flavioamieiro/dmx_servo_controller/README.md

# dmx_servo_controller

AMIEIRO + DELED : SERVO DMX Controller V0.1
