flavioamieiro/dmx_servo_controller/DMX_servo_controller_hardware/README.md

DMX servo controller

This source describes Open Hardware and is licensed under the CERN-OHL-S v2.
You may redistribute and modify this source and make products using it under
the terms of the [CERN-OHL-S v2](https://ohwr.org/cern_ohl_s_v2.txt).

Source location: https://github.com/flavioamieiro/Neopixel-Pico-Arcade

As per CERN-OHL-S v2 section 4, should You produce hardware based on this
source, You must where practicable maintain the Source Location visible on the
external case of the Gizmo or other products you make using this source.
