flavioamieiro/dmx_servo_controller/(threads)

Thread 1 (2023-08-16):

DmxInput: start_channel is not honored

MatheusMeM, 2023-08-16:
ORIGINAL:

https://github.com/jostlowe/Pico-DMX/issues/15](https://github.com/jostlowe/Pico-DMX/issues/15#issue-1080333671)
