flavioamieiro/dmx_servo_controller/DMX_servo_controller_hardware/DMX_servo_controller_hardware.pdf

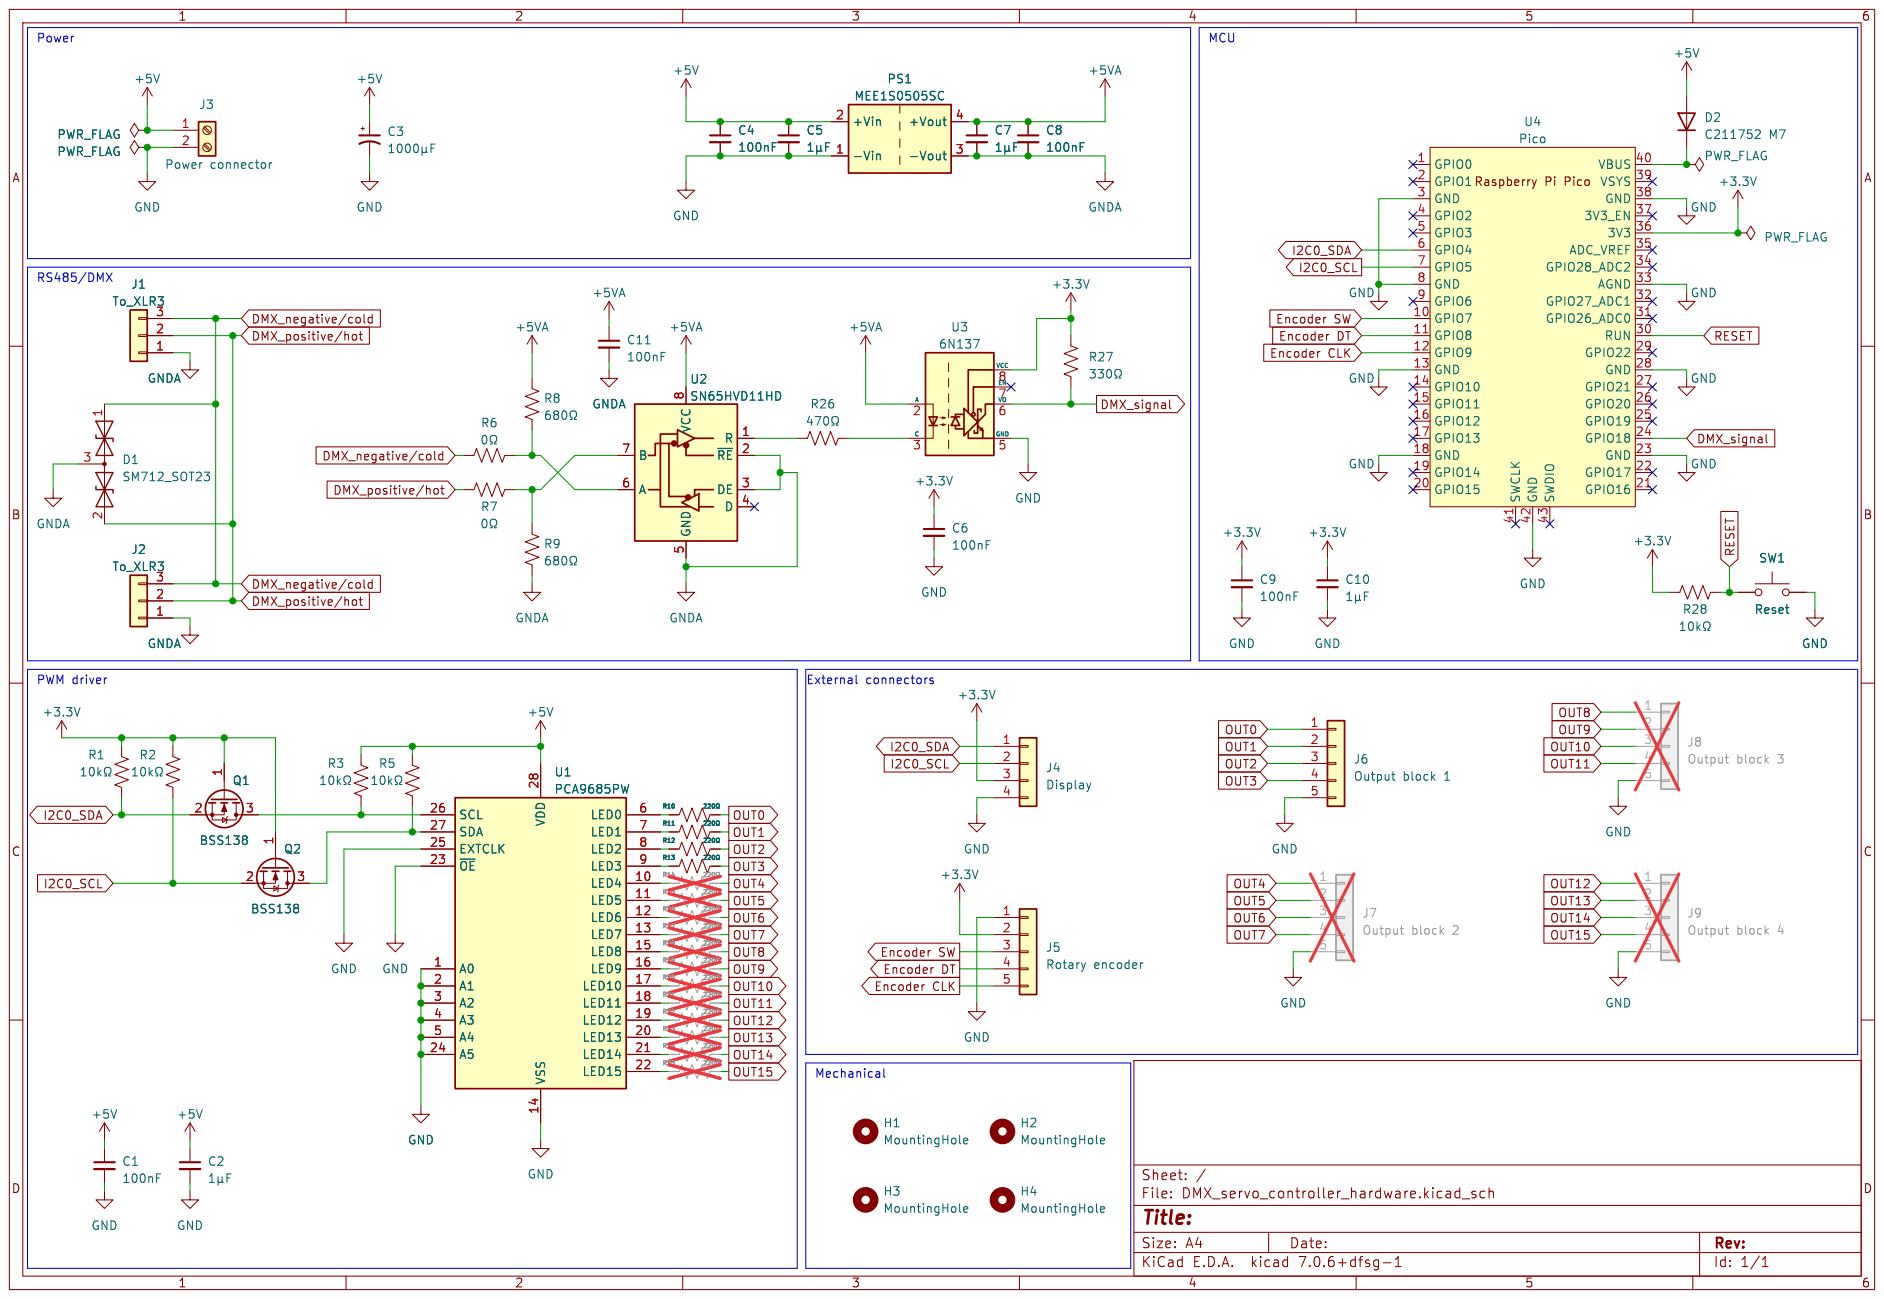
[picture p1: page 1]

Id: 1/1 Title: File: DMX_servo_controller_hardware.kicad_sch Sheet: /
