flavioamieiro/dmx_servo_controller/PWM_breakout_board/PWM_breakout_board.pdf

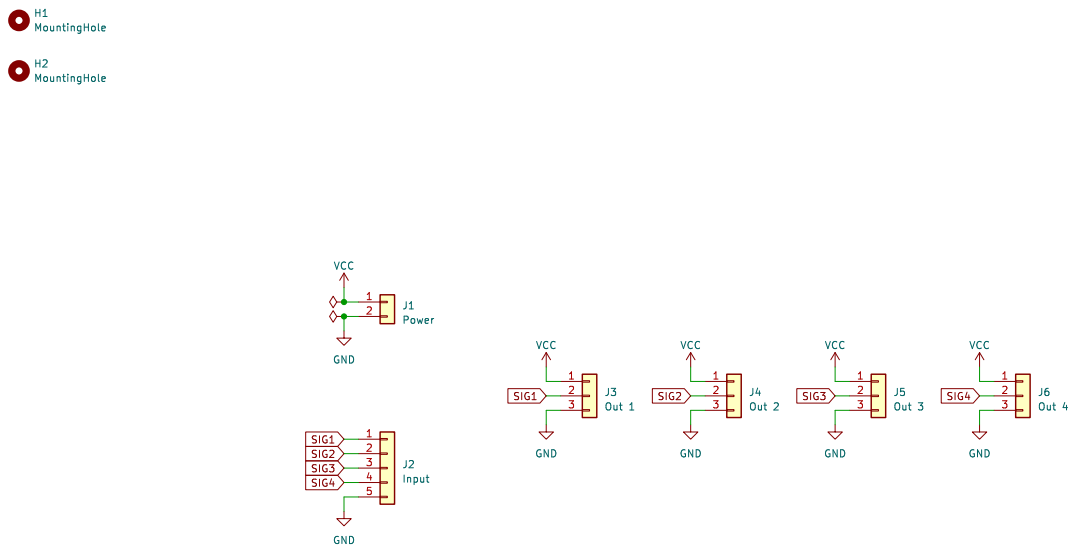
[picture p2: page 1]

Id: 1/1 Title: File: PWM_breakout_board.kicad_sch Sheet: /
