flavioamieiro/dmx_servo_controller/PWM_breakout_board/PWM_breakout_board.kicad_pcb

## KiCad design PWM_breakout_board/PWM_breakout_board.kicad_pcb (2023-07-26)

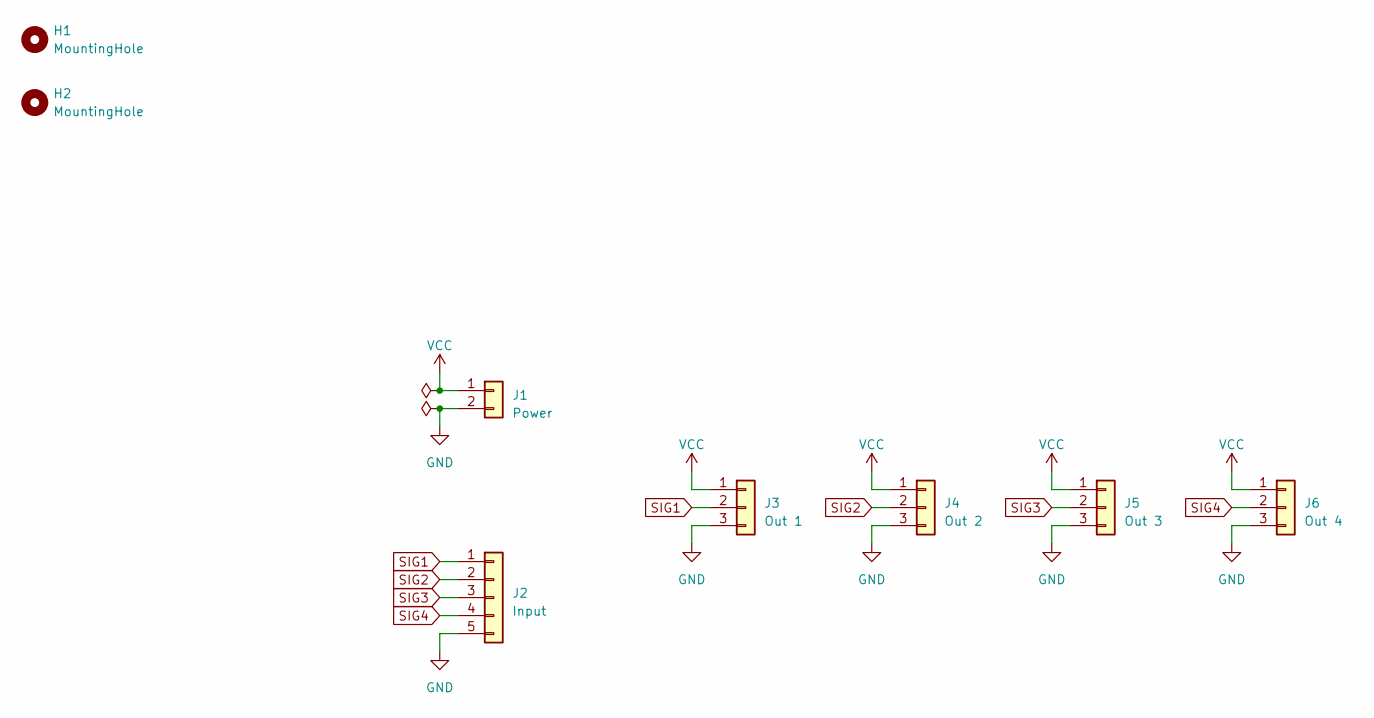
[picture p3: schematic PWM_breakout_board.kicad_sch]

Parts:
H1, H2: MountingHole; MountingHole_4.3mm_M4_ISO7380
J1: Power; TerminalBlock_bornier-2_P5.08mm
J2: Input; JST_XH_B5B-XH-AM_1x05_P2.50mm_Vertical
J3: Out 1; TerminalBlock_bornier-3_P5.08mm
J4: Out 2; TerminalBlock_bornier-3_P5.08mm
J5: Out 3; TerminalBlock_bornier-3_P5.08mm
J6: Out 4; TerminalBlock_bornier-3_P5.08mm

Connections:
GND: J1.2, J2.5, J3.3, J4.3, J5.3, J6.3
SIG1: J2.1, J3.2
SIG2: J2.2, J4.2
SIG3: J2.3, J5.2
SIG4: J2.4, J6.2
VCC: J1.1, J3.1, J4.1, J5.1, J6.1

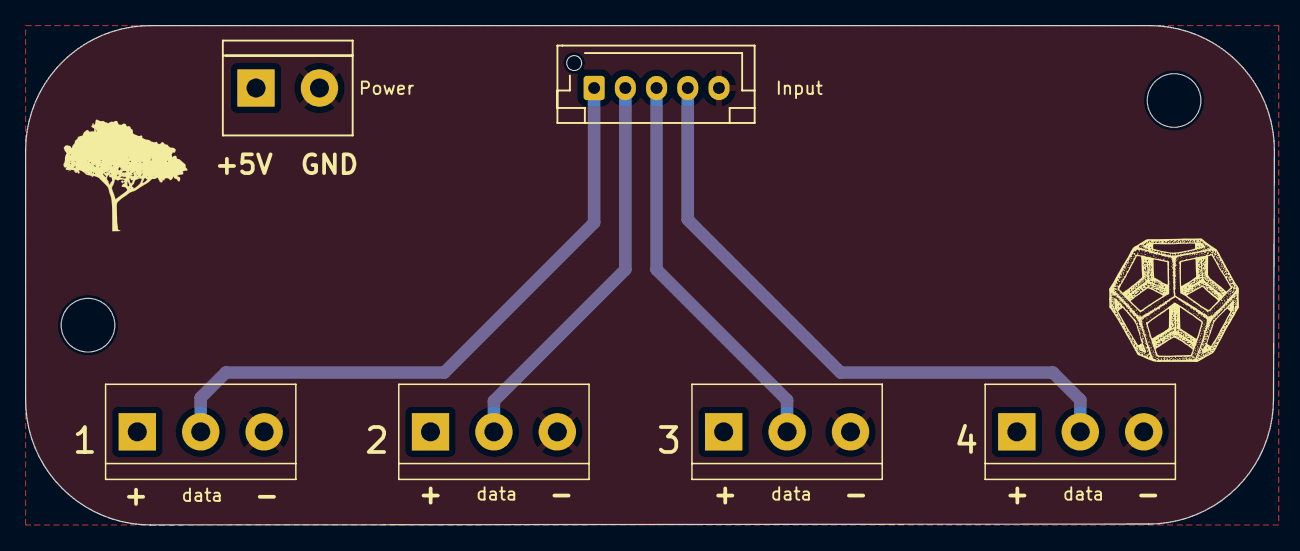
[picture p4: board PWM_breakout_board.kicad_pcb from above]

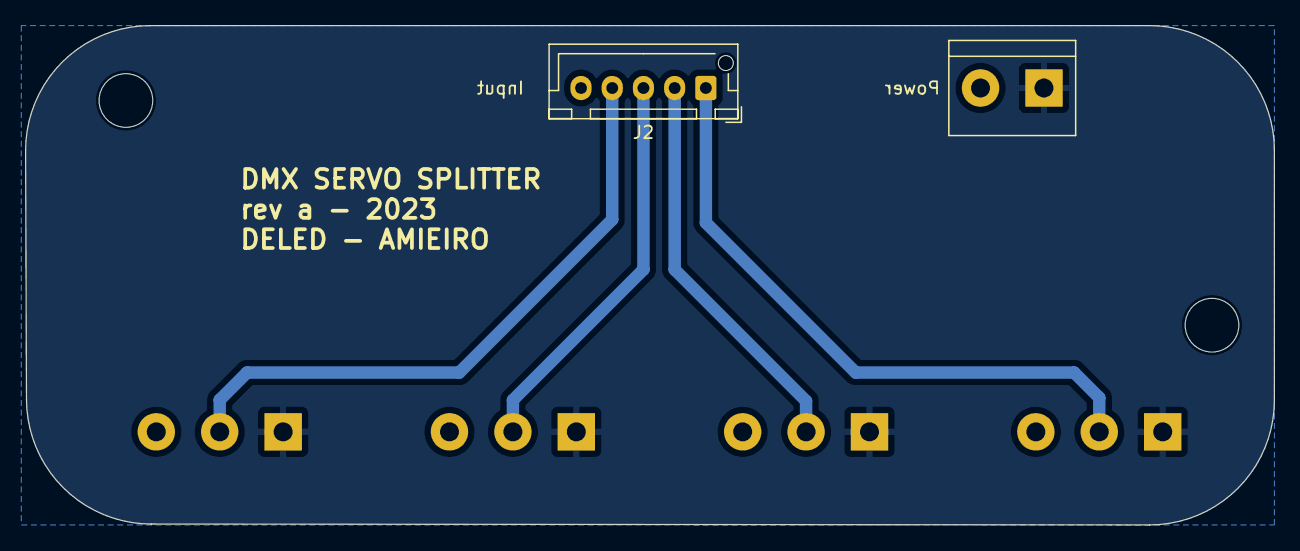
[picture p5: board PWM_breakout_board.kicad_pcb from below]

Board: 2 copper layers, 100.0 x 40.0 mm, 9 parts (2 on the bottom side), 6 nets.

Other parts of the board:
Ref**: Val**; ipe_logo_FSilk_10x10
