flavioamieiro/dmx_servo_controller/(commit log)

2023-03-13 Commit inicial
    [DMX_servo_controller_hardware.kicad_pcb, DMX_servo_controller_hardware.kicad_sch]
2023-03-13 Adiciona esquemático do protótipo de conexão do RS485
    Essa versão não tem ainda isolamento mas foi a que usamos para receber
    com sucesso mensagens DMX da mesa controladora.
    [DMX_servo_controller_hardware.kicad_sch]
2023-03-15 Adiciona código de exemplo pra ler 3 canais DMX
    Esse código funciona na IDE do Arduino usando o Arduino-pico [1]
    [1]: https://github.com/earlephilhower/arduino-pico
2023-03-15 Adiciona licença para a parte de hardware
2023-03-20 Adds Raspberry Pi pico symbol and footprint from ncarandini/KiCad-RP-Pico
    The footprint and symbol are taken from
    https://github.com/ncarandini/KiCad-RP-Pico which has a license that
    explicitly allows it to be used in projects without the same license.
    This commit also updates project files to Kicad 7.0.1
    [DMX_servo_controller_hardware.kicad_sch]
2023-03-21 Isolates DMX signal from the rest of the electronics
    We're using a 0505 5v DC/DC isolator for power and an 6N137 optocoupler
    for the signal.
    The 6N137 is supposed to work with 5V, but our tests (and other designs)
    showed that 3.3V works fine and means the optocoupler works as a level
    shifter.
    [DMX_servo_controller_hardware.kicad_sch]
2023-03-22 Moves XLR connector to a hierarchical sheet
    The XLR connectors will be in a daughter board that can be used as a
    breakout board for XLR connectors.
    [DMX_servo_controller_hardware.kicad_sch, XLR_daughter_board.kicad_sch]
2023-03-22 Adds Pi Pico to the schematics
    This also adds a connector for 5V power (a screw terminal that will be
    connected to the external power supply). The 3v3 rail will come from the
    pico's regulator.
    [DMX_servo_controller_hardware.kicad_sch, XLR_daughter_board.kicad_sch]
2023-03-22 Adds connections for display
    This also fixes the Reset switch (I was missing the signal on the
    push button) and adds an external connector for the XLR signal (In case
    we use the daughter board detached from the main board).
    [DMX_servo_controller_hardware.kicad_sch]
2023-03-22 Adds connector for rotary encoder
    The pinout needs to be reviewed when we decide on the actual module we
    will use.
    [DMX_servo_controller_hardware.kicad_sch]
2023-03-22 WIP: Adds PCA9685 PWM driver
    This adds the IC and some minimal circuitry around it, but there's still
    work to be done here.
    [DMX_servo_controller_hardware.kicad_sch]
2023-03-29 Adds pull-up resistors to PCA9685 i2c lines
    [DMX_servo_controller_hardware.kicad_sch]
2023-03-29 Adds external connectors for the servos
    [DMX_servo_controller_hardware.kicad_sch]
2023-03-29 Fixes GND pin 38 type in the pi pico symbol
2023-03-30 FIxes ERC errors
    [DMX_servo_controller_hardware.kicad_sch, XLR_daughter_board.kicad_sch]
2023-05-02 Renames example code
    Arduino prefers if the sketch is in a directory with the same name.
2023-05-03 Fixes OE and EXT_CLK pins on the PCA9685 schematics
    OE is active low, so it needs to be pulled to ground.
    [DMX_servo_controller_hardware.kicad_sch]
2023-05-03 Uses same i2c bus for display and pwm controller
    The devices have different addresses. There's no good reason for us not
    to use the same bus.
    [DMX_servo_controller_hardware.kicad_sch]
2023-05-03 First code example with most elements integrated
    For now, the code reads DMX input synchronously and sets channels 0 and
    15 to their position based on channel 1.
    Channels 2 and 3 define the min and max (respectively) duty cycle values
    for `setPWM` since at least the servos we tested on seem to not match
    the datasheet.
    The input value for all DMX channels is output on the OLED display.
2023-05-09 Adds test points to all unused channels in PWM controller
    This can help a lot with debugging.
    [DMX_servo_controller_hardware.kicad_sch]
2023-05-10 Allows controlling servos independently with each DMX channel
    This commit restructures the code to allow each servo to keep it's own
    state. This removes the temporary calibration channels that existed
    for debugging. A calibration wizzard should be included in the UI later.
2023-05-12 DMX_servo_controller_hardware/DMX_servo_controller_hardware-backups/ DMX_servo_controller_hardware/MCU_RaspberryPi_and_Boards.pretty/desktop.ini DMX_servo_controller_hardware/desktop.ini "Defini\303\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
    [DMX_servo_controller_hardware.kicad_sch]
2023-05-13 Powers PCA9685 from 5V rail
    With this, the PWM signal will be on the level the servos expect, since
    they will be powered with the same voltage. The i2c lines are level
    shifted since the RP2040 GPIOs are not 5V tolerant.
    [DMX_servo_controller_hardware.kicad_sch]
2023-05-13 Adds a diode to stop the USB from feeding the power supply when programming
    [DMX_servo_controller_hardware.kicad_sch]
2023-05-22 Fixes schematics symbols that were triggering ERC errors
    [DMX_servo_controller_hardware.kicad_sch, XLR_daughter_board.kicad_sch]
2023-05-22 Reasigns component designators
    [DMX_servo_controller_hardware.kicad_sch, XLR_daughter_board.kicad_sch]
2023-05-22 Adds power flag to the VUSB net after the diode
    This is necessary so the ERC will not complain about the pin do being
    driven.
    [DMX_servo_controller_hardware.kicad_sch]
2023-05-22 Adds minimal example code to interface with rotary encoder
    This uses Matthias Hertel's RotaryEncoder library[1].
    [1]: https://github.com/mathertel/RotaryEncoder
2023-05-22 Reorganizes code and fixes bug in servo update reference
    The loop function is now much easier to read and only calls specific
    functions that handle certain subsystems. Also, I don't know how to
    handle pointers.
    [dmx_servo_controller.ino]
2023-05-23 Final review of the schematics
    * Fixes SCL pull-up in PCA9685
    * Reviews pinouts
    * Adds series resistor to PWM signals
    * Adds bulk decoupling capacitor to 5V power rail
    [DMX_servo_controller_hardware.kicad_sch]
2023-05-26 Assigns footprints to some of the components
    [DMX_servo_controller_hardware.kicad_sch, XLR_daughter_board.kicad_sch]
2023-05-26 Changes schematic to have only header to plug the panel mounted XLR3 connectors
    We will use panel mounted XLR connector, so we don't need the daughter
    board and the PCB XLR connectors anymore. Instead, the external ones
    will connect to the PCB via 2 JST headers.
    [DMX_servo_controller_hardware.kicad_sch]
2023-05-26 Assigns footprint for test points
    We might want to have all test points going to one connector (01x06 pin
    header) to make the layout easier in the future.
    [DMX_servo_controller_hardware.kicad_sch]
2023-05-26 Reorder JST conectors and PCA9685 outputs for completion (OCD) / added DNP in 4out8 outputs / removed unnecessary resistor for upper 8 outputs of PCA9685 testpoints
    [DMX_servo_controller_hardware.kicad_sch]
2023-05-31 Adds footprint for reset pushbutton
    The footprint almost matches (and is definitely within tolerances) for
    the technical drawing and measurements taken from the pushbuttons to be
    used.
    [DMX_servo_controller_hardware.kicad_sch]
2023-06-01 Adds 6N137-X007T footprint and assigns it in schematics
    The X007 variant of 6N137 uses an SMD gullwing package. The footprint
    was created following the technical drawing in vishay's datasheet[1].
    [1]: https://www.vishay.com/docs/84732/6n137.pdf
    [DMX_servo_controller_hardware.kicad_sch]
2023-06-01 Uses screw terminals for servo output connectors
    [DMX_servo_controller_hardware.kicad_sch]
2023-06-01 Uses DIP-8 footprint for SN65HVD12
    [DMX_servo_controller_hardware.kicad_sch]
2023-06-01 Switches symbol and footprint for diode on VUSB
    We're using the C211752[1] from yangjie, but since there's no schematic
    symbol for it, I replaced it with the MRA4003T3G since it has the same
    functionality and footprint and changed the value to reflect the correct
    part number.
    [1]: https://datasheet.lcsc.com/lcsc/1912111437_Yangzhou-Yangjie-Elec-Tech-M7_C211752.pdf
    [DMX_servo_controller_hardware.kicad_sch]
2023-06-01 Adds output for all PWM channels
    They are marked as unpopulated, but it's a good idea to route all
    outputs since we can than populate them if we want more channels.
    [DMX_servo_controller_hardware.kicad_sch, servo_outputs.kicad_sch]
2023-06-02 Reasigns all component designations
    Now that the schematic is closer to the final configuration we can have
    a better distribution of designators.
    [DMX_servo_controller_hardware.kicad_sch, servo_outputs.kicad_sch]
2023-06-02 Moves DMX input to GPIO15 on the Pico
    GPIO0 is UART_TX, which was causing issues[1].
    [1]: https://github.com/jostlowe/Pico-DMX/issues/26#issuecomment-1573000484
    [DMX_servo_controller_hardware.kicad_sch]
2023-06-02 Reads DMX messages asynchronously
    This way, we don't need to block until a message is sent, so we can
    process input from the rotary encoder even if no controller is sending
    data to the DMX bus.
2023-06-02 Removes minimum delay between servo moves
    Even though we're reading DMX input asynchronously, we're still only
    processing the data once per loop. Our code is already complex enough
    that by the time we loop through again we're already past the threshold
    we were setting.
2023-06-05 Changes PWM output connectors
    The outputs will be broken out into a JST connector (with ground) in
    blocks of 4 that can then be brought to the connectors to be used by the
    end-user. This is a more flexible design, as we can have the break-out
    board placed in a better place in the enclosure and also permits power
    to be delivered directly to the breakout board.
    [DMX_servo_controller_hardware.kicad_sch, XLR_daughter_board.kicad_sch, servo_outputs.kicad_sch]
2023-06-05 Adds schematics for PWM signal breakout board
    [PWM_breakout_board.kicad_pcb, PWM_breakout_board.kicad_sch]
2023-06-05 Assigns footprints to symbols in PWM breakout board schematics
    [PWM_breakout_board.kicad_sch]
2023-06-05 Adds first draft of breakout board PCB mechanical design
    This is a very rough sketch for now.
    [PWM_breakout_board.kicad_pcb]
2023-06-05 Uses similar 3D model for terminal blocks in the breakout board
    The Phoenix connectors are very similar to ours and the 3d models don't
    have any major impact, so we can use them since the bornier symbols
    don't have one.
    [PWM_breakout_board.kicad_pcb]
2023-06-05 Roughly routes PWM breakout board as a first draft
    [PWM_breakout_board.kicad_pcb]
2023-06-05 Updates PCBnew file
    [DMX_servo_controller_hardware.kicad_pcb]
2023-06-05 Fixes 3d model path for PI Pico footprint
2023-06-06 Fixes footprints for resistors in the main schematics
    [DMX_servo_controller_hardware.kicad_sch]
2023-06-06 Sets main board PCB as 4 layers and set some defaults
    [DMX_servo_controller_hardware.kicad_pcb]
2023-06-06 Adds four M4 mounting holes to main board
    [DMX_servo_controller_hardware.kicad_sch]
2023-06-06 Imports schematic into PCB file and roughly separates components in blocks
    [DMX_servo_controller_hardware.kicad_pcb]
2023-06-06 Fixes decoupling in PCA9685
    When changing the power supply for the IC, I forgot to change the
    decoupling caps.
    [DMX_servo_controller_hardware.kicad_sch]
2023-06-06 Regroups components in PCB
    This is still far from a final positioning, but the groups are more
    coherent now.
    [DMX_servo_controller_hardware.kicad_pcb]
2023-06-15 Switches display code to use SSD1306 OLEDs
    The displays we sourced use this controller. Since the code to actually
    interact with the display uses the Adafruit GFX library, the replacement
    is almost drop-in.
    [dmx_servo_controller.ino]
2023-07-02 First draft routing of the DMX section of the PCB
    This is far from the final layout, but it might help to start
    visualizing things.
    [DMX_servo_controller_hardware.kicad_pcb]
2023-07-02 Repositions rest of the components to route them in an easier way
    [DMX_servo_controller_hardware.kicad_pcb]
2023-07-02 Moves DMX signal input to GPIO18
    This will make it much easier to route the board.
    [DMX_servo_controller_hardware.kicad_sch]
2023-07-03 Reassigns pins in the code to match schematics
2023-07-03 First draft route for everything that was unrouted
    There's definitely a lot to improve still, but all nets are connected.
    [DMX_servo_controller_hardware.kicad_pcb]
2023-07-14 Edits some of the silkscreen an adjusts positioning slightly
    [DMX_servo_controller_hardware.kicad_pcb]
2023-07-14 Fixes DRC errors
    There are a lot of warnings left, but the errors are fixed (for now).
    [DMX_servo_controller_hardware.kicad_pcb]
2023-07-14 Reorganizes component positioning/layout
    The connectors are now all close to the edge o the board and grouped by
    function.
    The space between components in the DMX and uC sections was reduced,
    leaving some space to reduce the overall board size later a bit if we
    decide to.
    [DMX_servo_controller_hardware.kicad_pcb]
2023-07-14 Fixes DRC warnings
    This commit also hides the silkscreen for all the pins in the Pico.
    [DMX_servo_controller_hardware.kicad_pcb]
2023-07-14 Increases trace thickness for DMX signal
    [DMX_servo_controller_hardware.kicad_pcb]
2023-07-17 Via stitching, add C11 decoupling cap (transciever), layout adjusts
    [DMX_servo_controller_hardware.kicad_pcb, DMX_servo_controller_hardware.kicad_sch]
2023-07-18 add personal logo + infos into main board, edited F.silk labels into main board, changed dimensions of daughter board + reposition of components, included logo .pretty into project.
    [DMX_servo_controller_hardware.kicad_pcb, PWM_breakout_board.kicad_pcb]
2023-07-18 Adds personal logo to the PCB
    [DMX_servo_controller_hardware.kicad_pcb]
2023-07-18 Adds recess for USB connector
    [DMX_servo_controller_hardware.kicad_pcb]
2023-07-18 Updates footprints in breakout board to fix DRC warnings
    [PWM_breakout_board.kicad_pcb]
2023-07-18 Adds personal logo do PWM breakout board
    [PWM_breakout_board.kicad_pcb]
2023-07-18 Adds silkscreen to outputs in breakout board
    [PWM_breakout_board.kicad_pcb]
2023-07-26 Finalizes PCB
    * Changes connector descriptions that didn't match schematics
    * Reviews silkscreen
    * Minor layout changes
    [DMX_servo_controller_hardware.kicad_pcb, DMX_servo_controller_hardware.kicad_sch]
2023-07-26 Generates gerber files from PCB
    [DMX_servo_controller_hardware-B_Cu.gbr, DMX_servo_controller_hardware-B_Mask.gbr, DMX_servo_controller_hardware-B_Paste.gbr, DMX_servo_controller_hardware-B_Silkscreen.gbr, DMX_servo_controller_hardware-Edge_Cuts.gbr, DMX_servo_controller_hardware-F_Cu.gbr, DMX_servo_controller_hardware-F_Mask.gbr, DMX_servo_controller_hardware-F_Paste.gbr]
2023-07-26 Generates gerber files for splitter
    [PWM_breakout_board-B_Cu.gbr, PWM_breakout_board-B_Mask.gbr, PWM_breakout_board-B_Paste.gbr, PWM_breakout_board-B_Silkscreen.gbr, PWM_breakout_board-Edge_Cuts.gbr, PWM_breakout_board-F_Cu.gbr, PWM_breakout_board-F_Mask.gbr, PWM_breakout_board-F_Paste.gbr]
2023-07-26 Adds schematic PDFs
2023-07-26 Adds zip files with generated Gerbers
2023-08-16 Added file for OLED and Rotary Encoder menu Handling Created barebones example for debuging DMX comm
2023-08-25 Adds very simple (and untested) implementation of servo min value setting
    This allows the change of the min_pos value of each servo, which should
    take effect immediately.
    Note: the values are not yet saved to flash
    The code has a lot of duplication and should probably be refactored
    later.
2023-08-25 Adds simple (and untested) implementation for setting servo max values
    All the caveates from the implementation (in the last commit) of min
    values apply here also.
2023-08-28 Revert "alteration in menu_with_memory - WIP"
    This reverts commit fc7660216aca39dfabe0624e600f1e978795dfe0.
    [building_menu.ino, menu_with_memory.ino]
2023-08-28 Fixes Servo_limits menu return going back to main menu -> now going to servo menu, as expected
    [menu_with_memory.ino]
2024-01-28 ADDED V1.2 of firmware implementation, servo limit range in menu quick fix
    [servo_controller_v1.2.ino]
2024-01-28 Added BOM plugin to kicad and its generated files
